BleepLabs/ACC-Audio-Electonics-kit/README.md

# ACC Audio Electonics kit

Simple Noise maker kit with amplifier and speaker used in my Audio Electonics course  
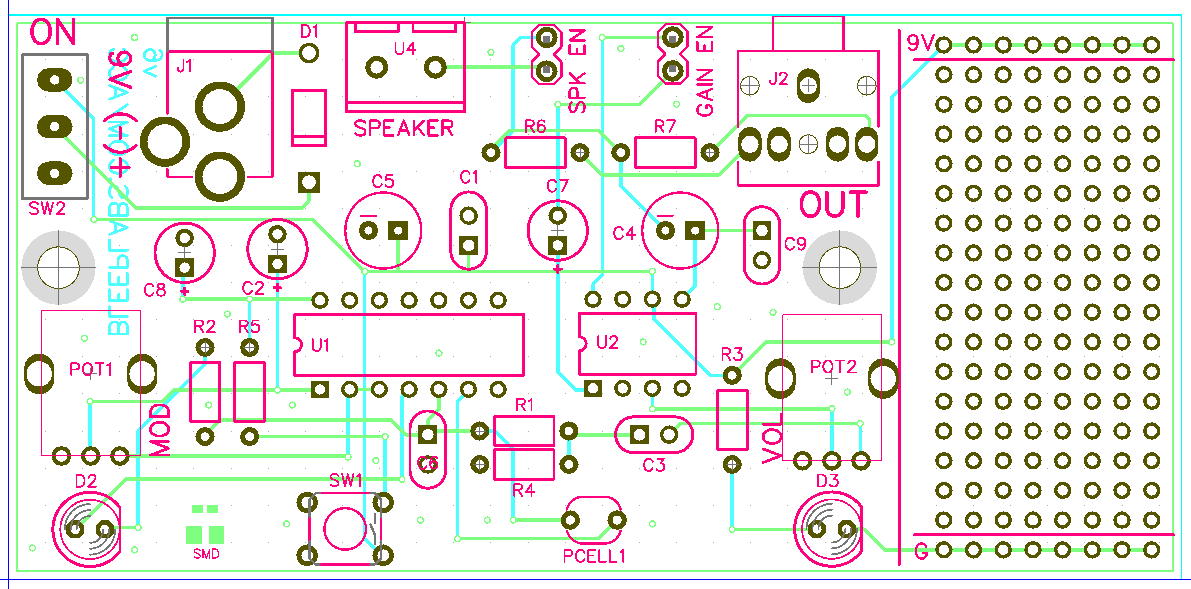
[picture p1: acc-kit-v6.png]
PCB
