BleepLabs/ACC-Audio-Electonics-kit/acc-kit-v6-schematic.png

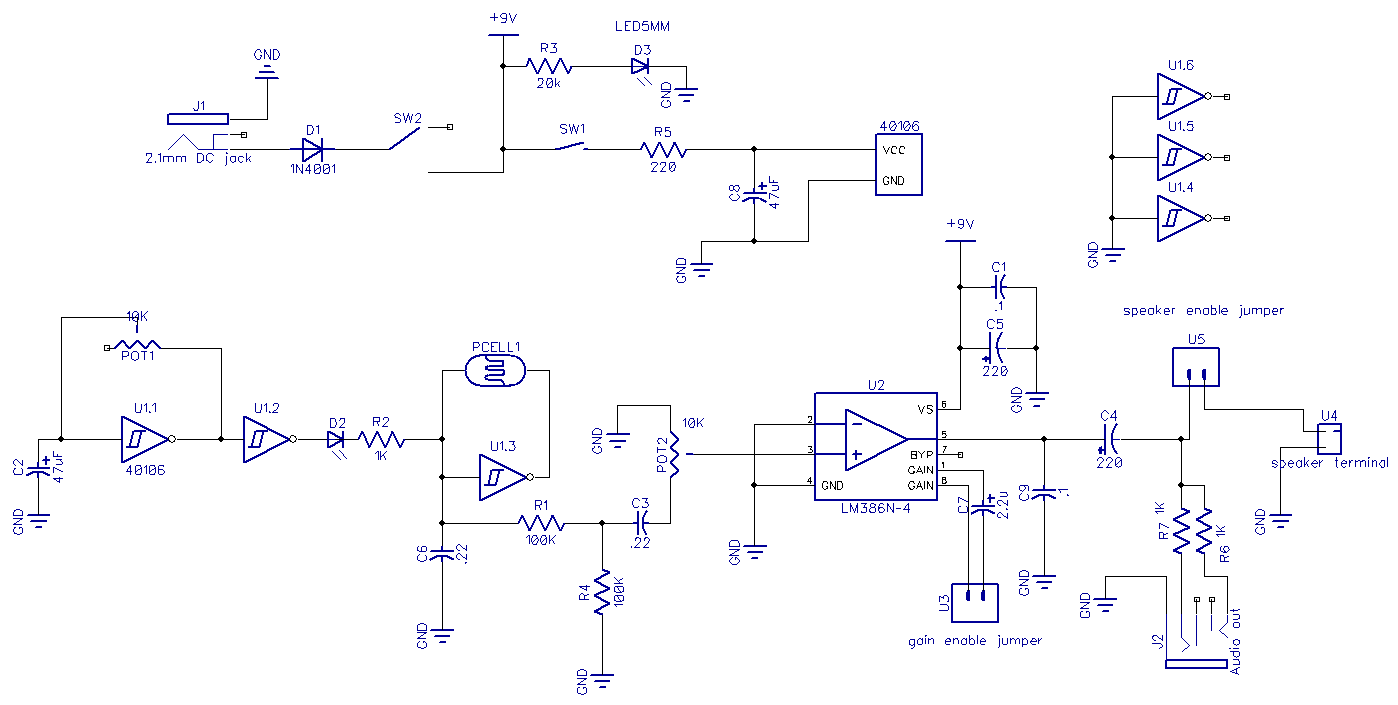
acc-kit-v6-schematic.png
