BleepLabs/ACC-Audio-Electonics-kit/ACC kit v6 parts list.xlsx

Audio Electronics Kit Parts
Refrence | Value | Description
C1 | 0.1u | Capacitor | Small tan
C9 | 0.1u | Capacitor | Small tan
C3 | 0.22u | Capacitor | Small blue
C6 | 0.22u | Capacitor | Small blue
C7 | 2.2u | Capacitor (Polar) | Small cylinder black
C4 | 220u | Capacitor (Polar) | Largest cylinder blue
C5 | 220u | Capacitor (Polar) | Largest cylinder blue
C2 | 47u | Capacitor (Polar) | Large cylinder blue
C8 | 47u | Capacitor (Polar) | Large cylinder blue
D2 | Blue | LED
D3 | Green | LED
D1 | 1N4001 | Diode | Small black cylinder with silver stripe
PCELL1 |  | Photocell | With black spacer
R5 | 220 | Resistor | red red brown gold
R1 | 100k | Resistor | brown black yellow gold
R4 | 100k | Resistor | brown black yellow gold
R2 | 1k | Resistor | brown black red gold
R6 | 1k | Resistor | brown black red gold
R7 | 1k | Resistor | brown black red gold
R3 | 20k | Resistor | red black orange gold
U1 |  | 14 pin DIP socket / 40106 IC
U2 |  | 8 pin DIP socket / 386 IC
U4 |  | Screw termainls for speaker
POT1 | 10k | Potentiometer
POT2 | 10k | Potentiometer
J1 |  | 2.1mm DC jack
J2 |  | 1/8” stereo jack
J3 |  | screw terminal | Green rectangle
SW1 |  | Momentray tactile switch square
SW2 |  | Slide switch
