BleepLabs/ACC-Audio-Electonics-kit/(list of files, drawings)

Other design files:
acc audio electronics synth v6.dch
acc kit v6.dip
